dombeef/monolith/monolith_arduino/espway-master/schematic/espway.png

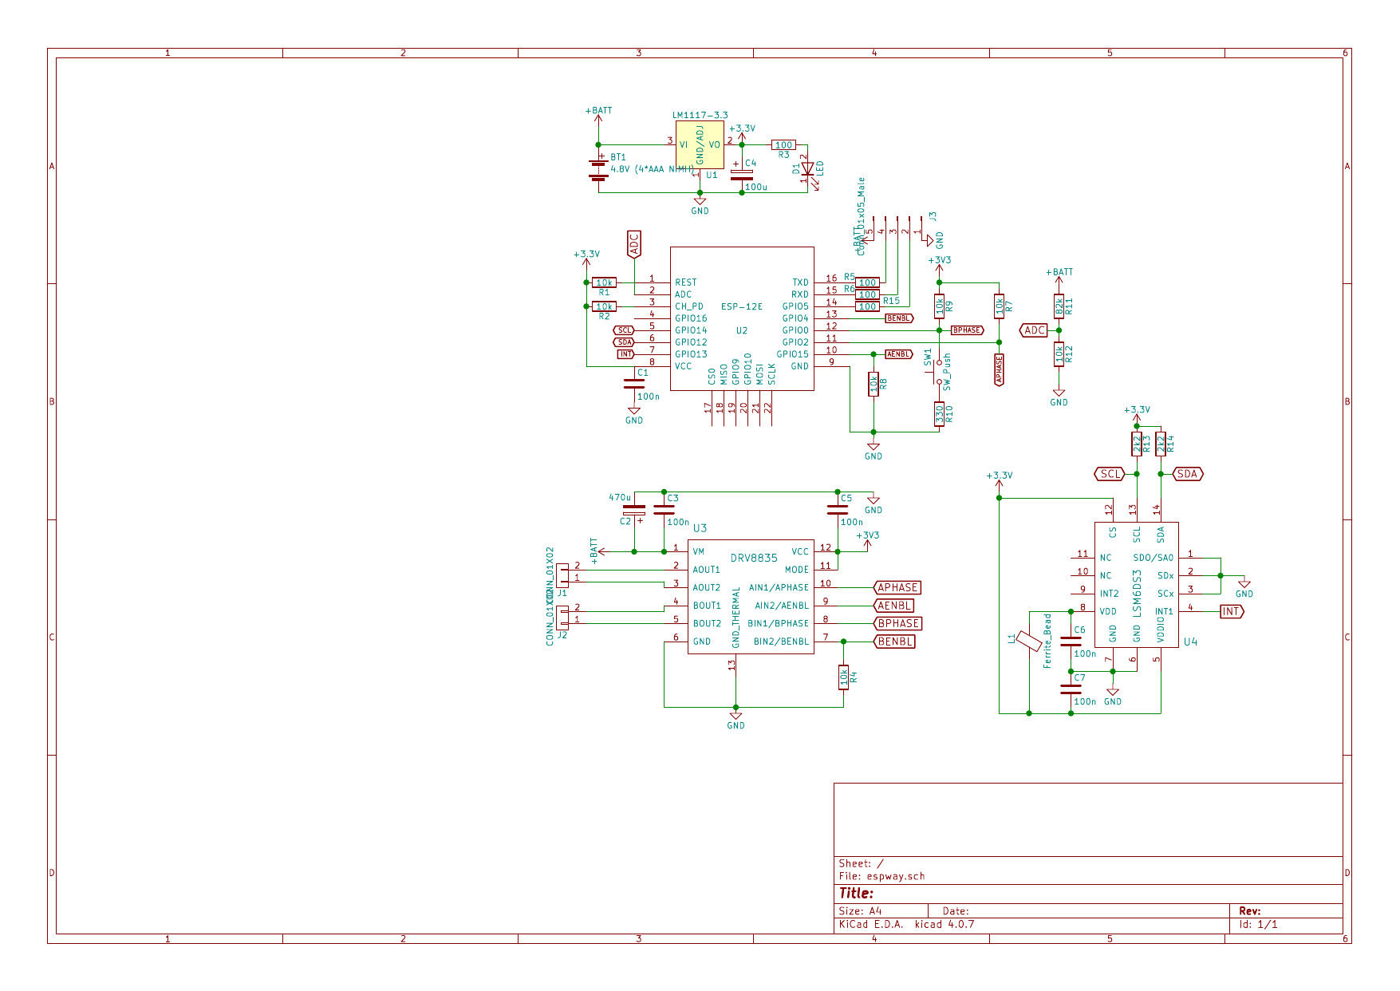
monolith_arduino/espway-master/schematic/espway.png
