dombeef/monolith/Monolith BOM.xlsx

items | quantity | quantity needed | cost | cost total | cost per unit | units possible | extra
L298N | 5 | 1 | 14.98 | 14.98 | 2.996 | 5 | https://www.amazon.com/DAOKI-Controller-H-Bridge-Stepper-Mega2560/dp/B00XAGRQTO
LM2596 DC Boost Converter | 6 | 1 | 11.59 | 11.59 | 1.931666667 | 6 | https://www.amazon.com/eBoot-LM2596-Converter-3-0-40V-1-5-35V/dp/B01GJ0SC2C?s=electronics
300 RPM 6v gearbox motor | 1 | 2 | 6.99 | 13.98 | 13.98 | 0.5 | https://www.amazon.com/BQLZR-33x12mm-Gearbox-Gearwheel-Electric/dp/B01M02X1WJ?s=aps
ESP8266 ESP-12E | 2 | 1 | 9.99 | 9.99 | 4.995 | 2 | https://www.amazon.com/Makerfocus-ESP8266-Wireless-Transceiver-ESP-12E/dp/B01IK9SV9E
PCB from OSHpark | 3 | 1 | 11.45 | 11.45 | 3.816666667 | 3 | https://oshpark.com/shared_projects/3gzkshCR
MPU-6050 | 1 | 1 | 4.69 | 4.69 | 4.69 | 1 | https://www.amazon.com/Makerfire-MPU6050-Module-sensors-Accelerometer/dp/B008BOPN40?s=electronics
Lipo Battery charging circuit | 10 | 1 | 6.98 | 6.98 | 0.698 | 10 | https://www.amazon.com/McIgIcM-Battery-Charging-Charger-lithium/dp/B06XXYTRGK?s=electronics
WS2812B pcb module | 100 | 2 | 16.87 | 16.87 | 0.3374 | 50 | https://www.amazon.com/kuman-WS2812B-Addressable-Arduino-littlergb/dp/B01M5BEO1C
18650 battery | 2 | 1 | 13.99 | 13.99 | 6.995 | 2 | https://www.amazon.com/2500mah-discharge-Samsung-INR18650-25R-li-ion/dp/B00QKD4V4C?s=electronics
 |  |  |  | 0 | #DIV/0! | #DIV/0!
 |  |  |  | 0 | #DIV/0! | #DIV/0!
 |  | Total: |  | 104.52 | 40.43973333
