dombeef/monolith/monolith_catia/monolith_frame_p2.stl

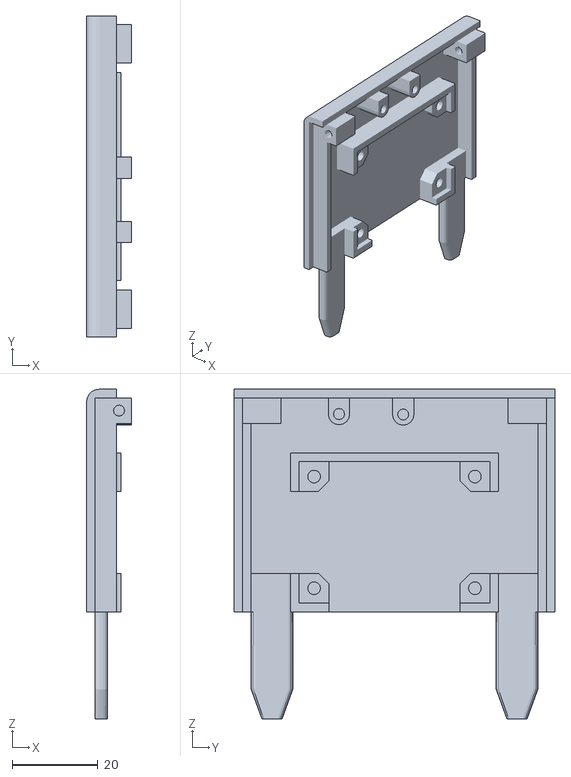
[picture p2: CAD file, 2018-01-04]
monolith_catia/monolith_frame_p2.stl
10.5 x 75.0 x 77.0
