dombeef/monolith/monolith_catia/monolith_frame_p2_front.stl

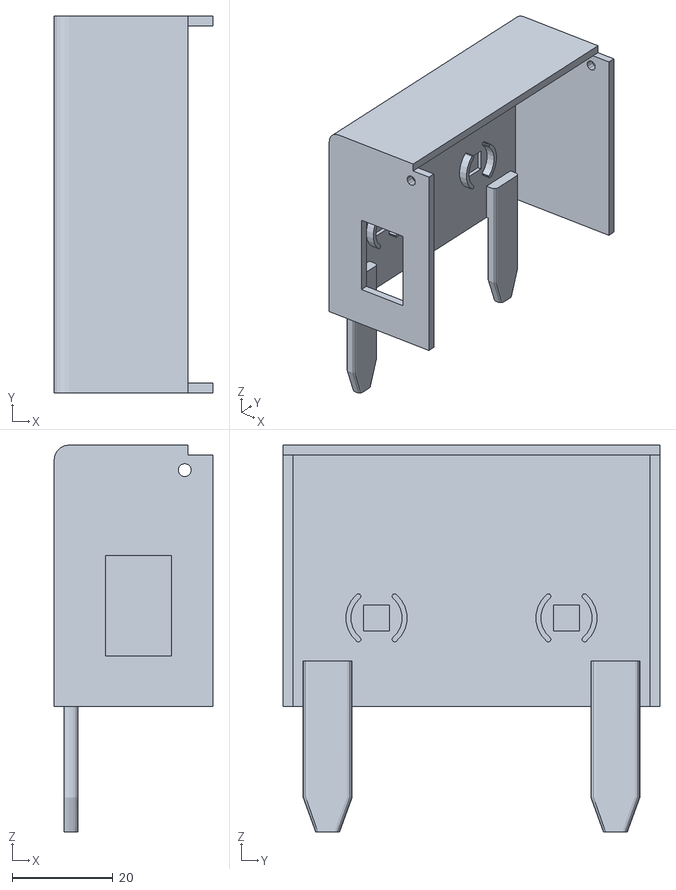
[picture p3: CAD file, 2018-01-04]
monolith_catia/monolith_frame_p2_front.stl
31.6 x 75.0 x 77.0
