dombeef/monolith/monolith_catia/monolith_frame_p1_front.stl

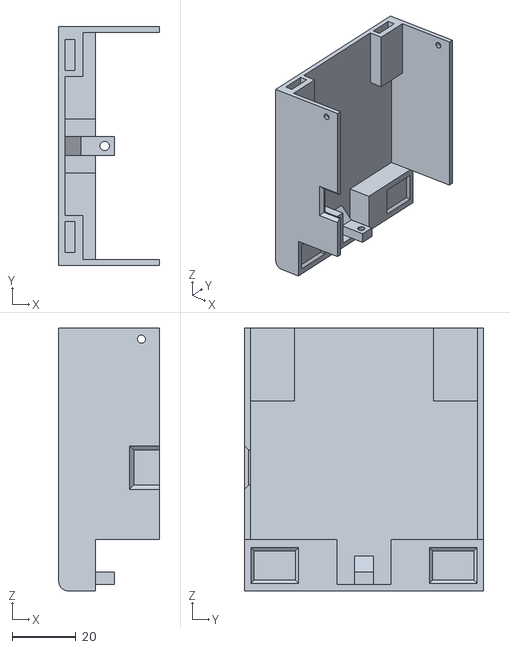
[picture p4: CAD file, 2017-09-29]
monolith_catia/monolith_frame_p1_front.stl
31.6 x 75.0 x 82.6
