dombeef/monolith/monolith_catia/monolith_frame_p1.stl

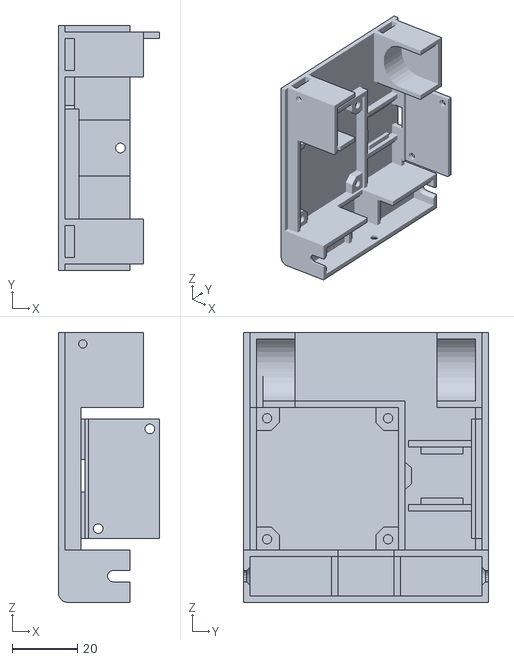
[picture p5: CAD file, 2017-08-24]
monolith_catia/monolith_frame_p1.stl
31.0 x 75.0 x 82.6
