dombeef/monolith/monolith_catia/wheel.stl

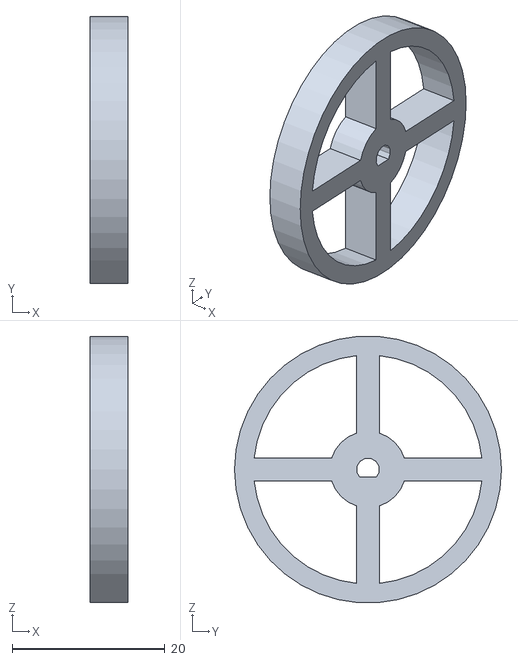
[picture p6: CAD file, 2017-08-06]
monolith_catia/wheel.stl
5.00 x 35.0 x 34.9
