dombeef/monolith/(list of files, cad)

Other CAD files:
monolith_catia/battery holder_test.CATPart
monolith_catia/l298n.CATPart
monolith_catia/monolith_assem.CATProduct
monolith_catia/monolith_frame_p1.CATPart
monolith_catia/monolith_frame_p1_front.CATPart
monolith_catia/monolith_frame_p2.CATPart
monolith_catia/monolith_frame_p2_front.CATPart
monolith_catia/wheel.CATPart
