dombeef/monolith/monolith_arduino/espway-master/schematic/espway.kicad_pcb

## KiCad design monolith_arduino/espway-master/schematic/espway.kicad_pcb (2020-11-15)

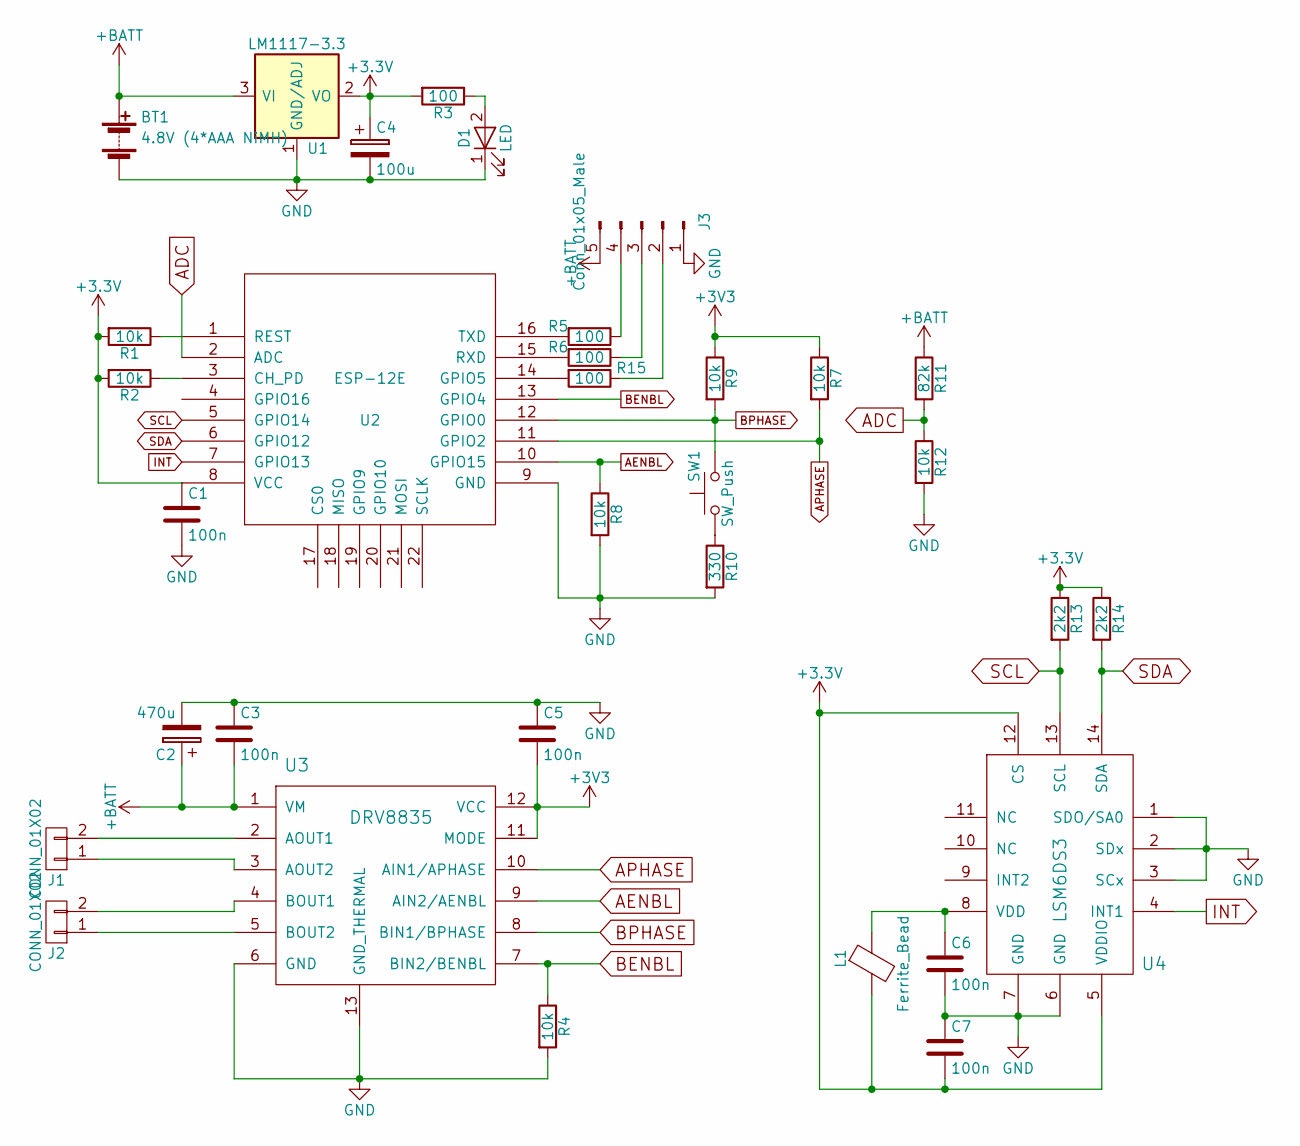
[picture p7: schematic espway.sch]

Parts:
BT1: 4.8V (4*AAA NiMH); WireConnection_1.20mmDrill
C1, C3, C5, C6, C7: 100n; C_0603
C2: 470u; CP_Elec_8x10
C4: 100u; CP_Elec_6.3x5.8
D1: LED; LED_0603
J1, J2: CONN_01X02; WireConnection_1.00mmDrill
J3: Conn_01x05_Male; Pin_Header_Angled_1x05_Pitch2.54mm
L1: Ferrite_Bead; L_0603
R1, R2, R4, R7, R8, R9, R12: 10k; R_0603
R3, R5, R6, R15: 100; R_0603
R10: 330; R_0603
R11: 82k; R_0603
R13, R14: 2k2; R_0603
SW1: SW_Push; SW_SPST_KMR2
U1: LM1117-3.3; SOT-223
U2: ESP-12E; ESP-12E_SMD
U3: DRV8835; WSON-12-1EP_3x2mm_Pitch0.5mm_ThermalVias
U4: LSM6DS3; Bosch_LGA-14_3x2.5mm_Pitch0.5mm

Connections:
+BATT: BT1.1 (+), C2.1, C3.2, J3.5, R11.1, U1.3 (VI), U3.1 (VM)
ADC: R11.2, R12.1, U2.2 (ADC)
AENBL: R8.1, U2.10 (GPIO15), U3.9 (AIN2/AENBL)
APHASE: R7.2, U2.11 (GPIO2), U3.10 (AIN1/APHASE)
BENBL: R4.1, U2.13 (GPIO4), U3.7 (BIN2/BENBL)
BPHASE: R9.2, SW1.2, U2.12 (GPIO0), U3.8 (BIN1/BPHASE)
GND: BT1.2 (-), C1.2, C2.2, C3.1, C4.2, C5.1, C6.2, C7.1, D1.1 (K), J3.1, R4.2, R8.2, R10.2, R12.2, U1.1 (GND/ADJ), U2.9 (GND), U3.6 (GND), U3.13 (GND_THERMAL), U4.1 (SDO/SA0), U4.2 (SDx), U4.3 (SCx), U4.6 (GND), U4.7 (GND)
INT: U2.7 (GPIO13), U4.4 (INT1)
unnamed: C6.1, L1.1, U4.8 (VDD)
unnamed: D1.2 (A), R3.1
unnamed: J1.1, U3.3 (AOUT2)
unnamed: J1.2, U3.2 (AOUT1)
unnamed: J2.1, U3.5 (BOUT2)
unnamed: J2.2, U3.4 (BOUT1)
unnamed: J3.2, R15.1
unnamed: J3.3, R6.1
unnamed: J3.4, R5.1
unnamed: R1.1, U2.1 (REST)
unnamed: R2.1, U2.3 (CH_PD)
unnamed: R5.2, U2.16 (TXD)
unnamed: R6.2, U2.15 (RXD)
unnamed: R10.1, SW1.1
unnamed: R15.2, U2.14 (GPIO5)
SCL: R13.2, U2.5 (GPIO14), U4.13 (SCL)
SDA: R14.2, U2.6 (GPIO12), U4.14 (SDA)

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
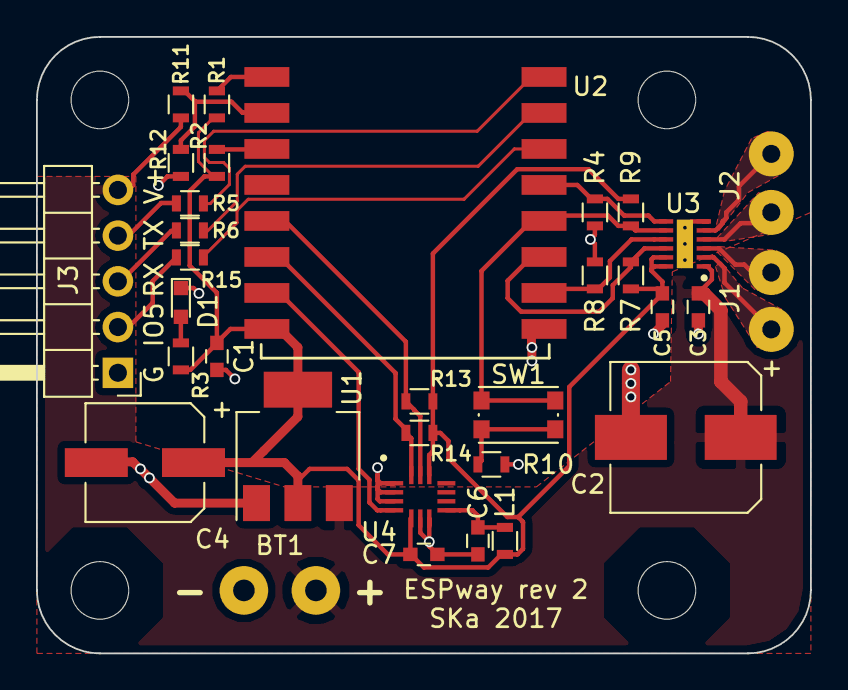
[picture p8: board espway.kicad_pcb from above]

Board: 2 copper layers, 43.0 x 34.2 mm, 33 parts (0 on the bottom side), 26 nets.
