dombeef/monolith/monolith_arduino/espway-arduino/espway-arduino/config.h

// Angle PID == the PID controller which regulates motor output signal to reach
// the target angle
#define ANGLE_KP 5.0
#define ANGLE_KI 10.0
#define ANGLE_KD 0.1
#define ANGLE_HIGH_KP 20.0
#define ANGLE_HIGH_KI ANGLE_KI
#define ANGLE_HIGH_KD ANGLE_KD
// Velocity PID == the PID controller which regulates target angle to reach
// the target velocity
#define VEL_KP 1.5
#define VEL_KI 0.5
#define VEL_KD 0.002

#define MOTOR_DEADBAND 0.0

#define STEERING_FACTOR 0.13
#define SPEED_CONTROL_FACTOR 0.67

#define TRAVEL_SPEED_SMOOTHING 0.002
#define TARGET_SPEED_SMOOTHING 0.001

// Madgwick beta == accelerometer correction factor. Should be fine-ish as is
#define MADGWICK_BETA 0.1

#define ORIENTATION_STABILIZE_DURATION 6000

#define FALL_LIMIT 0.75
#define RECOVER_LIMIT 0.2
#define HIGH_PID_LIMIT 0.2
#define ROLL_LIMIT 0.5

#define STABLE_ANGLE 0.01

#define GYRO_X_OFFSET -27
#define GYRO_Y_OFFSET -89
#define GYRO_Z_OFFSET 14

#define WINDUP_TIMEOUT 50000

// Undervoltage cutoff check modified for 3.7v battery
#define BATTERY_THRESHOLD 3.4
#define BATTERY_CALIBRATION_FACTOR 252
#define BATTERY_CHECK_INTERVAL 500
#define ENABLE_BATTERY_CHECK true
#define ENABLE_BATTERY_CUTOFF true

#define WIFI_SSID "MONOLITH"
#define WIFI_CHANNEL 1
