dombeef/monolith/monolith_arduino/espway-master/src/espway_server.cpp

/*
 * Firmware for a segway-style robot using ESP8266.
 * Copyright (C) 2017  Sakari Kapanen
 *
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
 * You should have received a copy of the GNU Lesser General Public License
 * along with this program.  If not, see <http://www.gnu.org/licenses/>.
 */

extern "C" {
#include <string.h>
#include <espressif/esp_common.h>
}
#include <lwip/altcp.h>
#include <lwip/tcpip.h>
#include <lwip/apps/httpd.h>

#include "lib/locks.h"
#include "espway.h"

static void httpd_websocket_save_config(struct altcp_pcb *pcb)
{
  uint8_t response;
  if (save_flash_config())
    response = RES_SAVE_CONFIG_SUCCESS;
  else
    response = RES_SAVE_CONFIG_FAILURE;
  httpd_websocket_write(pcb, &response, 1, WS_BIN_MODE);
}

static bool httpd_websocket_clear_config(struct altcp_pcb *pcb)
{
  uint8_t response;
  // Clear the configuration by writing config version zero
  bool success = clear_flash_config();
  if (success)
  {
    response = RES_CLEAR_CONFIG_SUCCESS;
    load_hardcoded_config();
  }
  else
  {
    response = RES_CLEAR_CONFIG_FAILURE;
  }
  httpd_websocket_write(pcb, &response, 1, WS_BIN_MODE);
  return success;
}

static void send_pid_params(struct altcp_pcb *pcb, pid_controller_index idx)
{
  uint8_t buf[14];
  buf[0] = RES_PID_PARAMS;
  buf[1] = idx;
  int32_t *params = (int32_t *)(&buf[2]);
  {
    MutexLock lock(pid_mutex);
    params[0] = my_config.pid_coeffs_arr[idx].p;
    params[1] = my_config.pid_coeffs_arr[idx].i;
    params[2] = my_config.pid_coeffs_arr[idx].d;
  }
  httpd_websocket_write(pcb, buf, sizeof(buf), WS_BIN_MODE);
}

static void send_orientation(struct altcp_pcb *pcb)
{
  uint8_t buf[5];
  buf[0] = RES_ORIENTATION;
  int16_t *qdata = (int16_t *)&buf[1];
  orientation my_orientation = get_orientation();
  qdata[0] = my_orientation.sin_pitch / 2;
  qdata[1] = my_orientation.sin_roll / 2;
  httpd_websocket_write(pcb, buf, sizeof(buf), WS_BIN_MODE);
}

static void httpd_websocket_cb(struct altcp_pcb *pcb, uint8_t *data,
                         uint16_t data_len, uint8_t mode)
{
  if (data_len == 0 || mode != WS_BIN_MODE) return;

  uint8_t msgtype = data[0];
  uint8_t *payload = &data[1];
  data_len -= 1;
  int8_t *signed_data;
  pid_controller_index pid_index;
  int32_t *i32_data;
  uint8_t res;

  switch (msgtype)
  {
    case STEERING:
      // Parameters: velocity (int8_t), turn rate (int8_t)
      if (data_len != 2) break;
      signed_data = (int8_t *)payload;
      set_steering((FLT_TO_Q16(SPEED_CONTROL_FACTOR) * signed_data[1]) / 128,
        (FLT_TO_Q16(STEERING_FACTOR) * signed_data[0]) / 128);
      break;

    case REQ_ORIENTATION:
      if (data_len != 0) break;
      send_orientation(pcb);
      break;

    case REQ_SET_PID_PARAMS:
      // Parameters: pid index (uint8_t), P (q16/int32_t), I (q16), D (q16)
      if (data_len != 13) break;

      pid_index = (pid_controller_index)payload[0];
      i32_data = (int32_t *)(&payload[1]);
      if (pid_index < (sizeof(pid_settings_arr) / sizeof(pid_settings_arr[0])))
      {
        update_pid_controller(pid_index, i32_data[0], i32_data[1],
            i32_data[2]);
        res = RES_SET_PID_PARAMS_ACK;
        httpd_websocket_write(pcb, &res, 1, WS_BIN_MODE);
      }

      break;

    case REQ_GET_PID_PARAMS:
      if (data_len != 1) break;
      if (payload[0] < (sizeof(pid_settings_arr) / sizeof(pid_settings_arr[0])))
      {
        send_pid_params(pcb, (pid_controller_index)payload[0]);
      }
      break;

    case REQ_LOAD_FLASH_CONFIG:
      if (data_len != 0) break;
      load_config();
      res = RES_LOAD_FLASH_CONFIG_DONE;
      httpd_websocket_write(pcb, &res, 1, WS_BIN_MODE);
      break;

    case REQ_SAVE_CONFIG:
      if (data_len != 0) break;
      httpd_websocket_save_config(pcb);
      break;

    case REQ_CLEAR_CONFIG:
      if (data_len != 0) break;
      httpd_websocket_clear_config(pcb);
      break;
  }
}

static void battery_task(void *pvParameter)
{
  uint32_t battery_value = 0;
  for (;;)
  {
    battery_value = q16_exponential_smooth(battery_value, sdk_system_adc_read(),
        FLT_TO_Q16(0.25f));
    uint32_t battery_mv = (battery_value * BATTERY_FULL_SCALE_RANGE) / 1024;

    if (ENABLE_BATTERY_CUTOFF && battery_mv < BATTERY_THRESHOLD)
    {
      battery_cutoff();
      break;
    }

    {
      LwipCoreLock lock();
      uint8_t buf[3];
      buf[0] = BATTERY;
      uint16_t *payload = (uint16_t *)&buf[1];
      payload[0] = battery_mv;
      httpd_websocket_broadcast(buf, sizeof(buf), WS_BIN_MODE);
    }

    vTaskDelay(BATTERY_CHECK_INTERVAL / portTICK_PERIOD_MS);
  }

  vTaskDelete(NULL);
}

void httpd_task(void *pvParameters)
{
  xTaskCreate(battery_task, "Battery task", 256, NULL, uxTaskPriorityGet(NULL), NULL);

  tCGI pCGIs[] = {
    {"/pid", [](int, int, char*[], char*[]) { return "/pid.html"; }}
  };
  http_set_cgi_handlers(pCGIs, sizeof (pCGIs) / sizeof (pCGIs[0]));

  httpd_websocket_register_callbacks(NULL, (tWsHandler) httpd_websocket_cb);
  httpd_init();

  for (;;);
}
