dombeef/monolith/monolith_arduino/espway-arduino/espway-arduino/src/mpu6050.c

/*
A lightweight library for reading and processing motion information
from a MPU-6050 sensor.
Copyright (C) 2016  Sakari Kapanen

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
You should have received a copy of the GNU General Public License
along with this program.  If not, see <http://www.gnu.org/licenses/>.
*/

#include "brzo_i2c/brzo_i2c.h"
#include "mpu6050.h"

static void mpu_write_register(const uint8_t addr,
    const uint8_t reg, const uint8_t value, bool stop) {
    uint8_t reg_value[] = { reg, value };
    brzo_i2c_write(reg_value, 2, !stop);
}

int mpu_read_registers(const uint8_t addr,
    uint8_t first_reg, const uint8_t len, uint8_t * const data) {
    brzo_i2c_start_transaction(MPU_ADDR, MPU_BITRATE);
    brzo_i2c_write(&first_reg, 1, true);
    brzo_i2c_read(data, len, false);
    return brzo_i2c_end_transaction();
}

int mpu_read_int_status(const uint8_t addr) {
    uint8_t tmp = 0;
    mpu_read_registers(addr, MPU_INT_STATUS, 1, &tmp);
    return tmp;
}

int mpu_read_raw_data(const uint8_t addr,
    int16_t * const data) {
    uint8_t *my_data = (uint8_t *)data;
    uint8_t buf[14];
    int ret = mpu_read_registers(MPU_ADDR, MPU_ACCEL_XOUT_H, 14, buf);
    if (ret != 0) { return ret; }

    my_data[0] = buf[1]; my_data[1] = buf[0];      // ACC_X
    my_data[2] = buf[3]; my_data[3] = buf[2];      // ACC_Y
    my_data[4] = buf[5]; my_data[5] = buf[4];      // ACC_Z
    my_data[6] = buf[9]; my_data[7] = buf[8];      // GYRO_X
    my_data[8] = buf[11]; my_data[9] = buf[10];    // GYRO_Y
    my_data[10] = buf[13]; my_data[11] = buf[12];  // GYRO_Z

    return ret;
}

bool mpu_init(void) {
    brzo_i2c_start_transaction(MPU_ADDR, MPU_BITRATE);
    // Wake up
    mpu_write_register(MPU_ADDR, MPU_PWR_MGMT_1,
        MPU_CLK_PLL_ZGYRO | MPU_TEMP_DIS, false);
    // 1000 Hz sampling
    mpu_write_register(MPU_ADDR, MPU_SMPRT_DIV, MPU_RATE, false);
    // 188 Hz LPF
    mpu_write_register(MPU_ADDR, MPU_CONFIG, 1, false);
    // Gyroscope min sensitivity
    mpu_write_register(MPU_ADDR, MPU_GYRO_CONFIG, 3 << 3, false);
    // Accel max sensitivity
    mpu_write_register(MPU_ADDR, MPU_ACCEL_CONFIG, 0, false);
    // Data ready interrupt on
    mpu_write_register(MPU_ADDR, MPU_INT_ENABLE, 1, false);
    // Check if the MPU still responds with its own address
    uint8_t addr = 0;
    mpu_read_registers(MPU_ADDR, MPU_WHO_AM_I, 1, &addr);
    return brzo_i2c_end_transaction() == 0 && addr == MPU_ADDR;
}

bool mpu_set_gyro_offsets(int16_t *offsets) {
    brzo_i2c_start_transaction(MPU_ADDR, MPU_BITRATE);
    uint8_t data[] = {
        MPU_XG_OFFS_USRH,
        offsets[0] >> 8, offsets[0] & 0xff,
        offsets[1] >> 8, offsets[1] & 0xff,
        offsets[2] >> 8, offsets[2] & 0xff
    };
    brzo_i2c_write(data, 7, false);
    return brzo_i2c_end_transaction();
}

void mpu_go_to_sleep(void) {
    mpu_write_register(MPU_ADDR, MPU_PWR_MGMT_1, 1 << 6, true);
}
