dombeef/monolith/(commit log)

2017-08-06 initial push
    doesnt work yet, mostly final on lower body housing and just need to add space in upper one
    [espway.kicad_pcb, espway.sch, l298n.CATPart, monolith_assem.CATProduct, monolith_frame_p1.CATPart, monolith_frame_p1.stl, monolith_frame_p1_front.CATPart, monolith_frame_p2.CATPart]
2017-08-10 updated 3d case
    [battery holder_test.CATPart, monolith_assem.CATProduct, monolith_frame_p1.CATPart, monolith_frame_p1_front.CATPart, monolith_frame_p1_front.stl, monolith_frame_p2.stl, monolith_frame_p2_front.CATPart]
2017-08-10 updated housing with space for battery
    [l298n.CATPart, monolith_assem.CATProduct, monolith_frame_p1.CATPart, monolith_frame_p1.stl, monolith_frame_p1_front.CATPart, monolith_frame_p1_front.stl, monolith_frame_p2.CATPart, monolith_frame_p2_front.CATPart]
2017-08-13 updated espway code + first working build
    Finally got it working mostly stable, now to work on the PCB
2017-08-19 Continued work on PCB
    [_saved_monolith.sch, monolith.kicad_pcb, monolith.sch]
2017-08-20 updated pcb
    Made smaller + added name/rev/date/etc
    [_saved_monolith.sch, monolith.kicad_pcb, monolith.sch]
2017-08-24 continued update pcb + housing
    [_saved_monolith.sch, monolith.kicad_pcb, monolith.sch, monolith_assem.CATProduct, monolith_frame_p1.CATPart, monolith_frame_p1.stl, monolith_frame_p1_front.CATPart, monolith_frame_p1_front.stl]
2017-09-29 lots of updates since github desktop glitched out
    updated pcb to v1.0 and am waiting for it to come back
    updated case design to mostly 1.0
    continued work on seperate controller using an esp8266
    added basic BOM using mostly just components from amazon so anyone can easily buy the components needed to build this
    [Monolith BOM.xlsx, l298n.CATPart, monolith.kicad_pcb, monolith.sch, monolith_assem.CATProduct, monolith_frame_p1.CATPart, monolith_frame_p1_front.CATPart, monolith_frame_p1_front.stl]
2018-01-04 updated frame + working on fixing code
    [monolith_assem.CATProduct, monolith_frame_p2.stl, monolith_frame_p2_front.CATPart, monolith_frame_p2_front.stl]
2020-11-15 added espway-master
    [espway.kicad_pcb, espway.sch]
