dombeef/monolith/(notices)

Notices in the files:
monolith_arduino/espway-arduino/espway-arduino/src/brzo_i2c/examples/ADT7420.ino:
Brzo_i2c is free software: you can redistribute it and/or modify
it under the terms of the GNU General Public License as published by
the Free Software Foundation, either version 3 of the License, or
(at your option) any later version.
monolith_arduino/espway-master/src/espway.cpp:
This program is free software: you can redistribute it and/or modify
it under the terms of the GNU Lesser General Public License as published by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
monolith_arduino/espway-arduino/espway-arduino/src/pwm.c:
the Free Software Foundation; either version 2 of the License, or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
